wengkai/4x4-radio-modules/README.md

# 4x4-radio-modules
A series circuit board design for amateur radio device, packaged on a 4x4 cm PCB. Schmatic and PCB are in Jiallichuang format. Design notes are in Chinese.
