wengkai/4x4-radio-modules/(list of files, drawings)

Other design files:
G3106 XO/G3106.eprj
G3107 RXFrontEnd/G3107.eprj
G3108 AFBandpass/G3108.eprj
